thomasarmel/arduino_polytech_2019_2020/README.md

# arduino_polytech_2019_2020
Projet électronique avec Arduino Polytech Nice Sophia 2019-2020
