thomasarmel/arduino_polytech_2019_2020/documents divers/README.md

Ici on met les divers documents comme le cahier des charges ou le planning
