thomasarmel/arduino_polytech_2019_2020/Rapports seances/PREVOST/Prévost_Thomas_s6_10_02_2020.md

**Rapport de séance du Lundi 10 Février 2020 (séance 6):**

Pendant cette séance, nous nous sommes surtout consacrés à la partie matérielle du projet (à la base je comptais régler le problème mémoire de Vector).

Nous avons mis en place les moteurs pour pouvoir actionner "l'axe X". Les 2 moteurs tournent bien en même temps, aucun problème de ce côté.
Les classes Stepper et GroupStepper remplissent parfaitement leur rôle.

Le problème est que les moteurs frottent sur la structure en bois. Nous les faisons donc glisser sur un rail en métal pour rendre l'ensemble plus stable. Pour les rails, nous sommes allés au FabLab des profilés equerres en aluminium.
Nous les avons découpés, percés et assemblés à la structure.
