thomasarmel/arduino_polytech_2019_2020/Rapports seances/PREVOST/Prévost_Thomas_s1_13_12_2019.md

__Rapport de séance du Vendredi 13 Décembre 2019 (séance 1):__

Le weekend dernier, je suis allé me renseigner sur l'utilisation de Github. J'ai trouvé un excellent cours sur OpenClassrooms: https://openclassrooms.com/fr/courses/5641721-utilisez-git-et-github-pour-vos-projets-de-developpement
J'avais déjà manipulé un petit peu Github notamment pendant mon stage cet été mais ce cours m'a permis d'utiliser cet outil plus en profondeur. Cependant, pour ce projet, on utilisera Github essentiellement comme hébergeur, et non pas pour gérer un projet de façon "professionnelle".

Pendant la séance, je me suis occupé à faire fonctionner des moteurs pas-à-pas modèle QSH4218 en utilisant les drivers A4988. Le power point mis à disposition par l'enseignant ne détaillant pas précisément les branchements, je suis allé chercher les datasheets sur Internet. Vous les trouverez dans le répertoire *datasheets*.
L'exemple de programme pour faire fonctionner les moteurs pas-à-pas fourni dans le power point ne fonctionnait pas. En fait il fallait laisser un délai plus important entre chaque pas, chose que j'ai comprise assez rapidement en entendant le bruit du moteur.
Il a aussi fallu faire le tri entre les drivers fournis par l'enseignant (A4988) parce qu'une bonne partie ne fonctionnait plus.
Nous comptons utiliser les moteurs pas-à-pas pour les faire rouler sur une crémaillère, afin de déplacer la "tête d'impression" suivant les axes X et Y. Il faudra au total 3 ou 4 moteurs pas-à-pas.

Après ça, on s'est occupés avec Clara à construire la structure de notre machine, avec les pièces en bois fournies par l'enseignant.

Avant la prochaine séance, je compte organiser et optimiser les moteurs pas-à-pas ainsi que la partie logiciel liée.
Nous allons aussi commander des pièces en bois.
