thomasarmel/arduino_polytech_2019_2020/Rapports seances/README.md

Ici les rapports hebdomadaires de séance
