thomasarmel/arduino_polytech_2019_2020/src/README.md

Le code source du projet ainsi que des différentes bibliothèques que nous avons créées pour l'occasion...
