thomasarmel/arduino_polytech_2019_2020/datasheets/README.md

Ici, nous allons mettre toutes les fiches techniques des composants que nous allons utiliser, ainsi que les documentations, tutoriels...
La plupart des documents seront donc en pdf
