thomasarmel/arduino_polytech_2019_2020/Rapports seances/PREVOST/Prévost_Thomas_s8_02_03_2020.md

**Rapport de séance du Lundi 2 Mars 2020 (séance 8):**

Le Vendredi d'avant les vacances, j'ai fait des heures supplémentaires pour résoudre 2 problèmes:

Les vis de la structure étaient mal serrées (ça a été laborieux).

Les moteurs tournaient sans entraîner les roues dentées. Comme expliqué dans le rapport précédent, on a essayé de mettre de la thermocolle mais ça n'a évidemment pas fonctionné.
L'enseignant a proposé la solution suivante: coincer un petit clou entre le moteur et la roue dentée. C'est beaucoup moins facile à faire précisement que ce qu'on peut imaginer, mais après coup il s'avère que la roue est plutôt bien coincée.

Pour cette avant-dernière séance, on ne s'est occupés que de la structure.
On a essayé de faire tourner les moteurs mais le clou partait à chaque fois. La solution a été d'étaler de la thermocolle de partout.
Au final, on a réussi à faire tourner tous les moteurs, la vidéo se trouve dans le rapport de Clara.

Je me suis aussi occupé de la seringue pour mettre la pâte. Le moteur pour la presser a déjà été programmé à la séance précédente.
On a cherché comment l'attacher au "moteur Y": l'enseignant a proposé des serres câbles, ce que a plutôt bien fonctionné.

Pour ne plus s'embêter à devoir tout remonter à la séance prochaine, on n'a rien débranché.

La vidéo "où tous les moteurs fonctionnent" se trouve dans le rapport de Clara.
