thomasarmel/arduino_polytech_2019_2020/planning.pdf

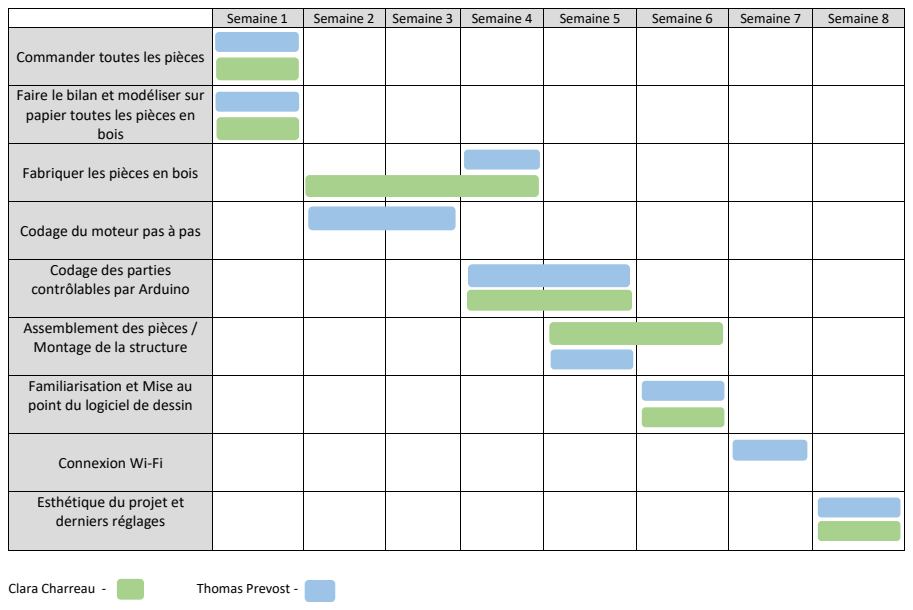
[picture p32: page 1]
Clara Charreau -; Thomas Prevost -

Semaine 1 | Semaine 2 | Semaine 3 | Semaine 4 | Semaine 5 | Semaine 6 | Semaine 7 | Semaine 8

Commander toutes les pièces

Faire le bilan et modéliser sur papier toutes les pièces en bois

Fabriquer les pièces en bois

Codage du moteur pas à pas

Codage des parties contrôlables par Arduino

Assemblement des pièces / Montage de la structure

Familiarisation et Mise au point du logiciel de dessin

Connexion Wi-Fi

Esthétique du projet et derniers réglages
