thomasarmel/arduino_polytech_2019_2020/src/pancarmemory.cpp

#include "pancarmemory.h"

using namespace pancar;

extern unsigned int __heap_start;
extern void *__brkval;

struct __freelist
{
  size_t sz;
  struct __freelist *nx;
};

extern struct __freelist *__flp;

int Memory::freeListSize()
{
    struct __freelist* current;
    int total = 0;
    for (current = __flp; current; current = current->nx)
    {
        total += 2;
        total += (int) current->sz;
    }
    return total;
}

int Memory::free()
{
    int free_memory;
    if ((int)__brkval == 0)
    {
        free_memory = ((int)&free_memory) - ((int)&__heap_start);
    }
    else
    {
        free_memory = ((int)&free_memory) - ((int)__brkval);
        free_memory += freeListSize();
    }
    return free_memory;
}
