thomasarmel/arduino_polytech_2019_2020/src/pancarvector.h

#ifndef PANCARVECTOR_H_INCLUDED
#define PANCARVECTOR_H_INCLUDED

/**
    NOTE AUX CORRECTEURS:
    J'explique ce code dans un pdf, dossier datasheets
*/

#if ARDUINO >= 100
  #include "Arduino.h"
#else
  #include "WProgram.h"
  #include "pins_arduino.h"
  #include "WConstants.h"
#endif

namespace pancar
{
template <typename T>
    class Vector
    {
    public:
        Vector();
        ~Vector();
        unsigned int size() const;
        void add(const T &element);
        void addValue(T value);
        T &get(unsigned int index) const;
        T &operator[](unsigned int index) const;
        void operator+=(Vector<T> v);
        void operator+=(const T &element);
        bool remove(unsigned int index, bool deletePointerToElement=false, void** pointerToPointerOfElementRemoved=nullptr);
        int searchPtr(T *ptr) const;
        bool getDestructorNeedsToDeletePointersToElements() const;
        void setDestructorNeedsToDeletePointersToElements(bool needs);

    protected:
        unsigned int m_size;
        void *m_firstElementArray[2];
        bool m_destructorNeedsToDeletePointersToElements;
    };

    template <typename T>
    Vector<T>::Vector() : m_size(0), m_destructorNeedsToDeletePointersToElements(false)
    {}

    template <typename T>
    Vector<T>::~Vector()
    {
        if(m_size>=1)
        {
            unsigned int size=m_size;
            for(unsigned int i=0; i<size; i++)
            {
                remove((size-1)-i, m_destructorNeedsToDeletePointersToElements); /// Not really clean, sorry...
            }
        }
    }

    template <typename T>
    unsigned int Vector<T>::size() const
    {
        return m_size;
    }

    template <typename T>
    void Vector<T>::add(const T &element)
    {
        if(m_size==0)
        {
            m_firstElementArray[0]=(void*)&element;
            m_firstElementArray[1]=0;
        }
        else
        {
            void *pointerNext=&m_firstElementArray;
            for(unsigned int i=0; i<(m_size-1); i++)
            {
                pointerNext=(*((void*(*)[2])pointerNext))[1];
            }
            void **elementArray=(void**)malloc(sizeof(void*) * 2);
            elementArray[0]=(void*)&element;
            elementArray[1]=0;
            (*((void*(*)[2])pointerNext))[1]=(void*)elementArray;
        }
        m_size++;
    }

    template <typename T>
    void Vector<T>::addValue(T value)
    {
        add(*(new T(value)));
    }

    template<typename T>
    T &Vector<T>::get(unsigned int index) const
    {
        if(index==0)
        {
            return *((T*)(m_firstElementArray[0]));
        }
        void *pointerNext=m_firstElementArray[1];
        for(unsigned int i=0; i<(index-1); i++)
        {
            pointerNext=(*((void*(*)[2])pointerNext))[1];
        }
        return *((T*)(*((void*(*)[2])pointerNext))[0]);
    }

    template<typename T>
    T &Vector<T>::operator[](unsigned int index) const
    {
        return get(index);
    }

    template<typename T>
    void Vector<T>::operator+=(Vector<T> v)
    {
        for(unsigned int i=0; i<v.size(); i++)
        {
            add(v.get(i));
        }
    }

    template<typename T>
    void Vector<T>::operator+=(const T &element)
    {
        add(element);
    }

    template<typename T>
    bool Vector<T>::remove(unsigned int index, bool deletePointerToElement, void** pointerToPointerOfElementRemoved)
    {
        if(m_size<=index)
        {
            return false;
        }
        if(index==0)
        {
            if(pointerToPointerOfElementRemoved!=nullptr)
            {
                *pointerToPointerOfElementRemoved=m_firstElementArray[0];
            }
            if(deletePointerToElement)
            {
                delete m_firstElementArray[0];
            }
            m_firstElementArray[0]=(*((void*(*)[2])m_firstElementArray[1]))[0];
            m_firstElementArray[1]=(*((void*(*)[2])m_firstElementArray[1]))[1];
        }
        else
        {
            void *pointerNext=&m_firstElementArray;
            for(unsigned int i=0; i<(index-1); i++)
            {
                pointerNext=(*((void*(*)[2])pointerNext))[1];
            }
            void **pointerToDelete=(void**)((*((void*(*)[2])pointerNext))[1]);
            if(pointerToPointerOfElementRemoved!=nullptr)
            {
                *pointerToPointerOfElementRemoved=(*((void*(*)[2]) (*((void*(*)[2])pointerNext))[1] ))[0];
            }
            if(deletePointerToElement)
            {
                delete (*((void*(*)[2]) (*((void*(*)[2])pointerNext))[1] ))[0];
            }
            (*((void*(*)[2])pointerNext))[1]=(*((void*(*)[2]) (*((void*(*)[2])pointerNext))[1] ))[1];
            delete pointerToDelete;
        }
        m_size--;
        return true;
    }

    template<typename T>
    int Vector<T>::searchPtr(T *ptr) const
    {
        if((T*)(m_firstElementArray[0])==ptr)
        {
            return 0;
        }
        if(m_size>=2)
        {
            void *pointerNext=(void*)&m_firstElementArray;
            for(unsigned int i=1; i<m_size; i++)
            {
                pointerNext=(*((void*(*)[2])pointerNext))[1];
                if((T*)((*((void*(*)[2])pointerNext))[0]) == ptr)
                {
                    return i;
                }
            }
        }
        return -1;
    }

    template<typename T>
    bool Vector<T>::getDestructorNeedsToDeletePointersToElements() const
    {
        return m_destructorNeedsToDeletePointersToElements;
    }

    template<typename T>
    void Vector<T>::setDestructorNeedsToDeletePointersToElements(bool needs)
    {
        m_destructorNeedsToDeletePointersToElements=needs;
    }

    template<typename T>
    Vector<T> operator+(Vector<T> const& a, Vector<T> const& b)
    {
        Vector<T> v;
        for(unsigned int i=0; i<a.size(); i++)
        {
            v.add(a.get(i));
        }
        for(unsigned int i=0; i<b.size(); i++)
        {
            v.add(b.get(i));
        }
        return v;
    }
}

#endif // PANCARVECTOR_H_INCLUDED
